DIYCharles/DIYKeyboards/photos/img2.jpg

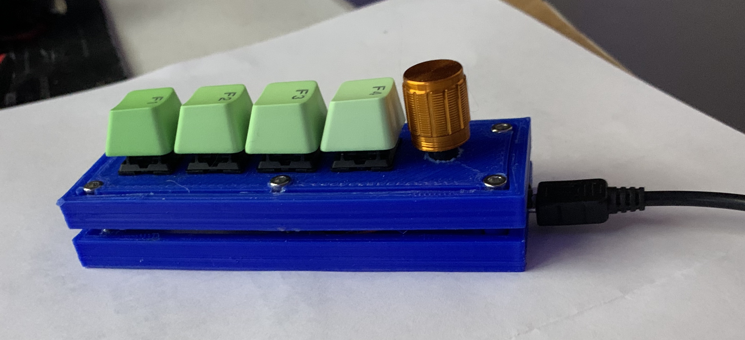
photos/img2.jpg
