DIYCharles/DIYKeyboards/3D parts/1x4 top plate v2.stl

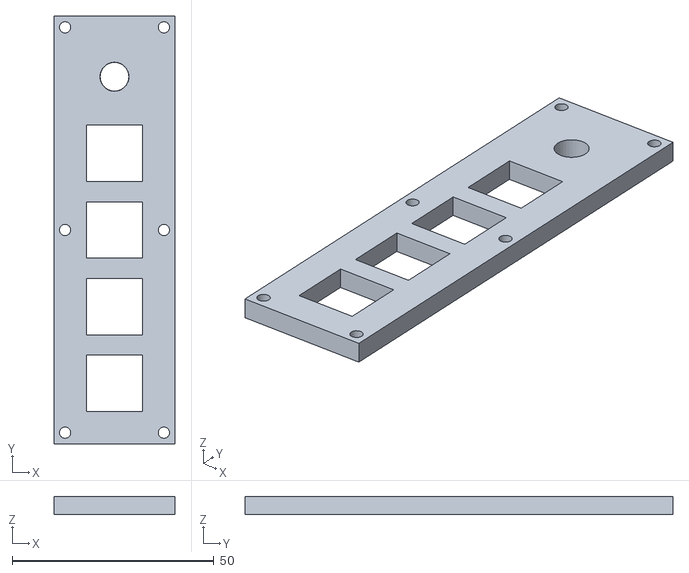
[picture p12: CAD file, 2020-05-27]
3D parts/1x4 top plate v2.stl
30.0 x 106.0 x 4.50
