DIYCharles/DIYKeyboards/3D parts/1x4 body bottom v6.stl

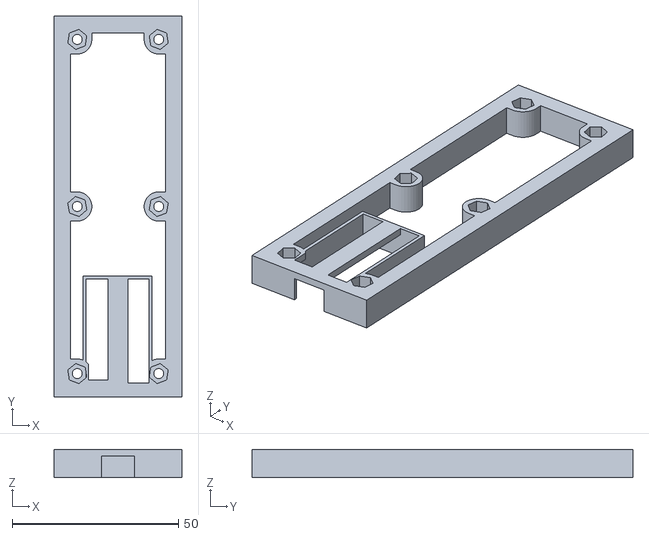
[picture p14: CAD file, 2020-05-27]
3D parts/1x4 body bottom v6.stl
38.5 x 114.5 x 8.50
