DIYCharles/DIYKeyboards/3D parts/1x4 micro retainer v3.stl

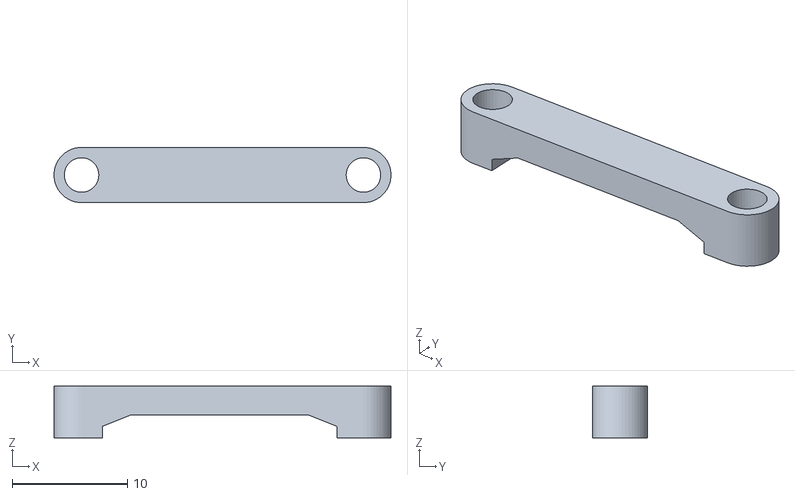
[picture p15: CAD file, 2020-05-27]
3D parts/1x4 micro retainer v3.stl
29.3 x 4.80 x 4.50
