DIYCharles/DIYKeyboards/QMK Firmware/kb/config.h

#ifndef CONFIG_H
#define CONFIG_H

#include "config_common.h"

/* USB Device descriptor parameter */
#define VENDOR_ID       0xFEED
#define PRODUCT_ID      0x6060
#define DEVICE_VER      0x0001
#define MANUFACTURER    qmkbuilder
#define PRODUCT         keyboard
#define DESCRIPTION     Keyboard

/* key matrix size */
#define MATRIX_ROWS 1
#define MATRIX_COLS 5

/* key matrix pins */
#define MATRIX_ROW_PINS { F7 }
#define MATRIX_COL_PINS { B3, B4, B1, B2, B5 }
#define UNUSED_PINS

#define ENCODERS_PAD_A { D1 }
#define ENCODERS_PAD_B { E6 }
#define ENCODER_DIRECTION_FLIP

/* COL2ROW or ROW2COL */
#define DIODE_DIRECTION COL2ROW

/* number of backlight levels */

#ifdef BACKLIGHT_PIN
#define BACKLIGHT_LEVELS 0
#endif

/* Set 0 if debouncing isn't needed */
#define DEBOUNCING_DELAY 5

/* Mechanical locking support. Use KC_LCAP, KC_LNUM or KC_LSCR instead in keymap */
#define LOCKING_SUPPORT_ENABLE

/* Locking resynchronize hack */
#define LOCKING_RESYNC_ENABLE

/* key combination for command */
#define IS_COMMAND() ( \
    keyboard_report->mods == (MOD_BIT(KC_LSHIFT) | MOD_BIT(KC_RSHIFT)) \
)

/* prevent stuck modifiers */
#define PREVENT_STUCK_MODIFIERS


#ifdef RGB_DI_PIN
#define RGBLIGHT_ANIMATIONS
#define RGBLED_NUM 0
#define RGBLIGHT_HUE_STEP 8
#define RGBLIGHT_SAT_STEP 8
#define RGBLIGHT_VAL_STEP 8
#endif

#endif
