DIYCharles/DIYKeyboards/(commit log)

2020-05-18 added 3d file, readme, and pics
    [16 key modded plate v1.stl, 16pad modded case.stl]
2020-05-18 Added advanced keyboard example with rotary encoder
2020-05-21 added another keyboard
    [16 key modded plate v1.stl, 16pad modded case.stl, base.stl, plate.stl]
2020-05-27 changed it
    [16 key modded plate v1.stl, 16pad modded case.stl, 1x4 body bottom v6.stl, 1x4 body space v3.stl, 1x4 micro retainer v3.stl, 1x4 top plate v2.stl, base.stl, plate.stl]
2021-01-19 adding gbl file of stl model
